kharar/STP-8100L-05/STP-8100L-05 reverse engineering.kicad_pcb

## KiCad design STP-8100L-05 reverse engineering.kicad_pcb (2023-08-08)

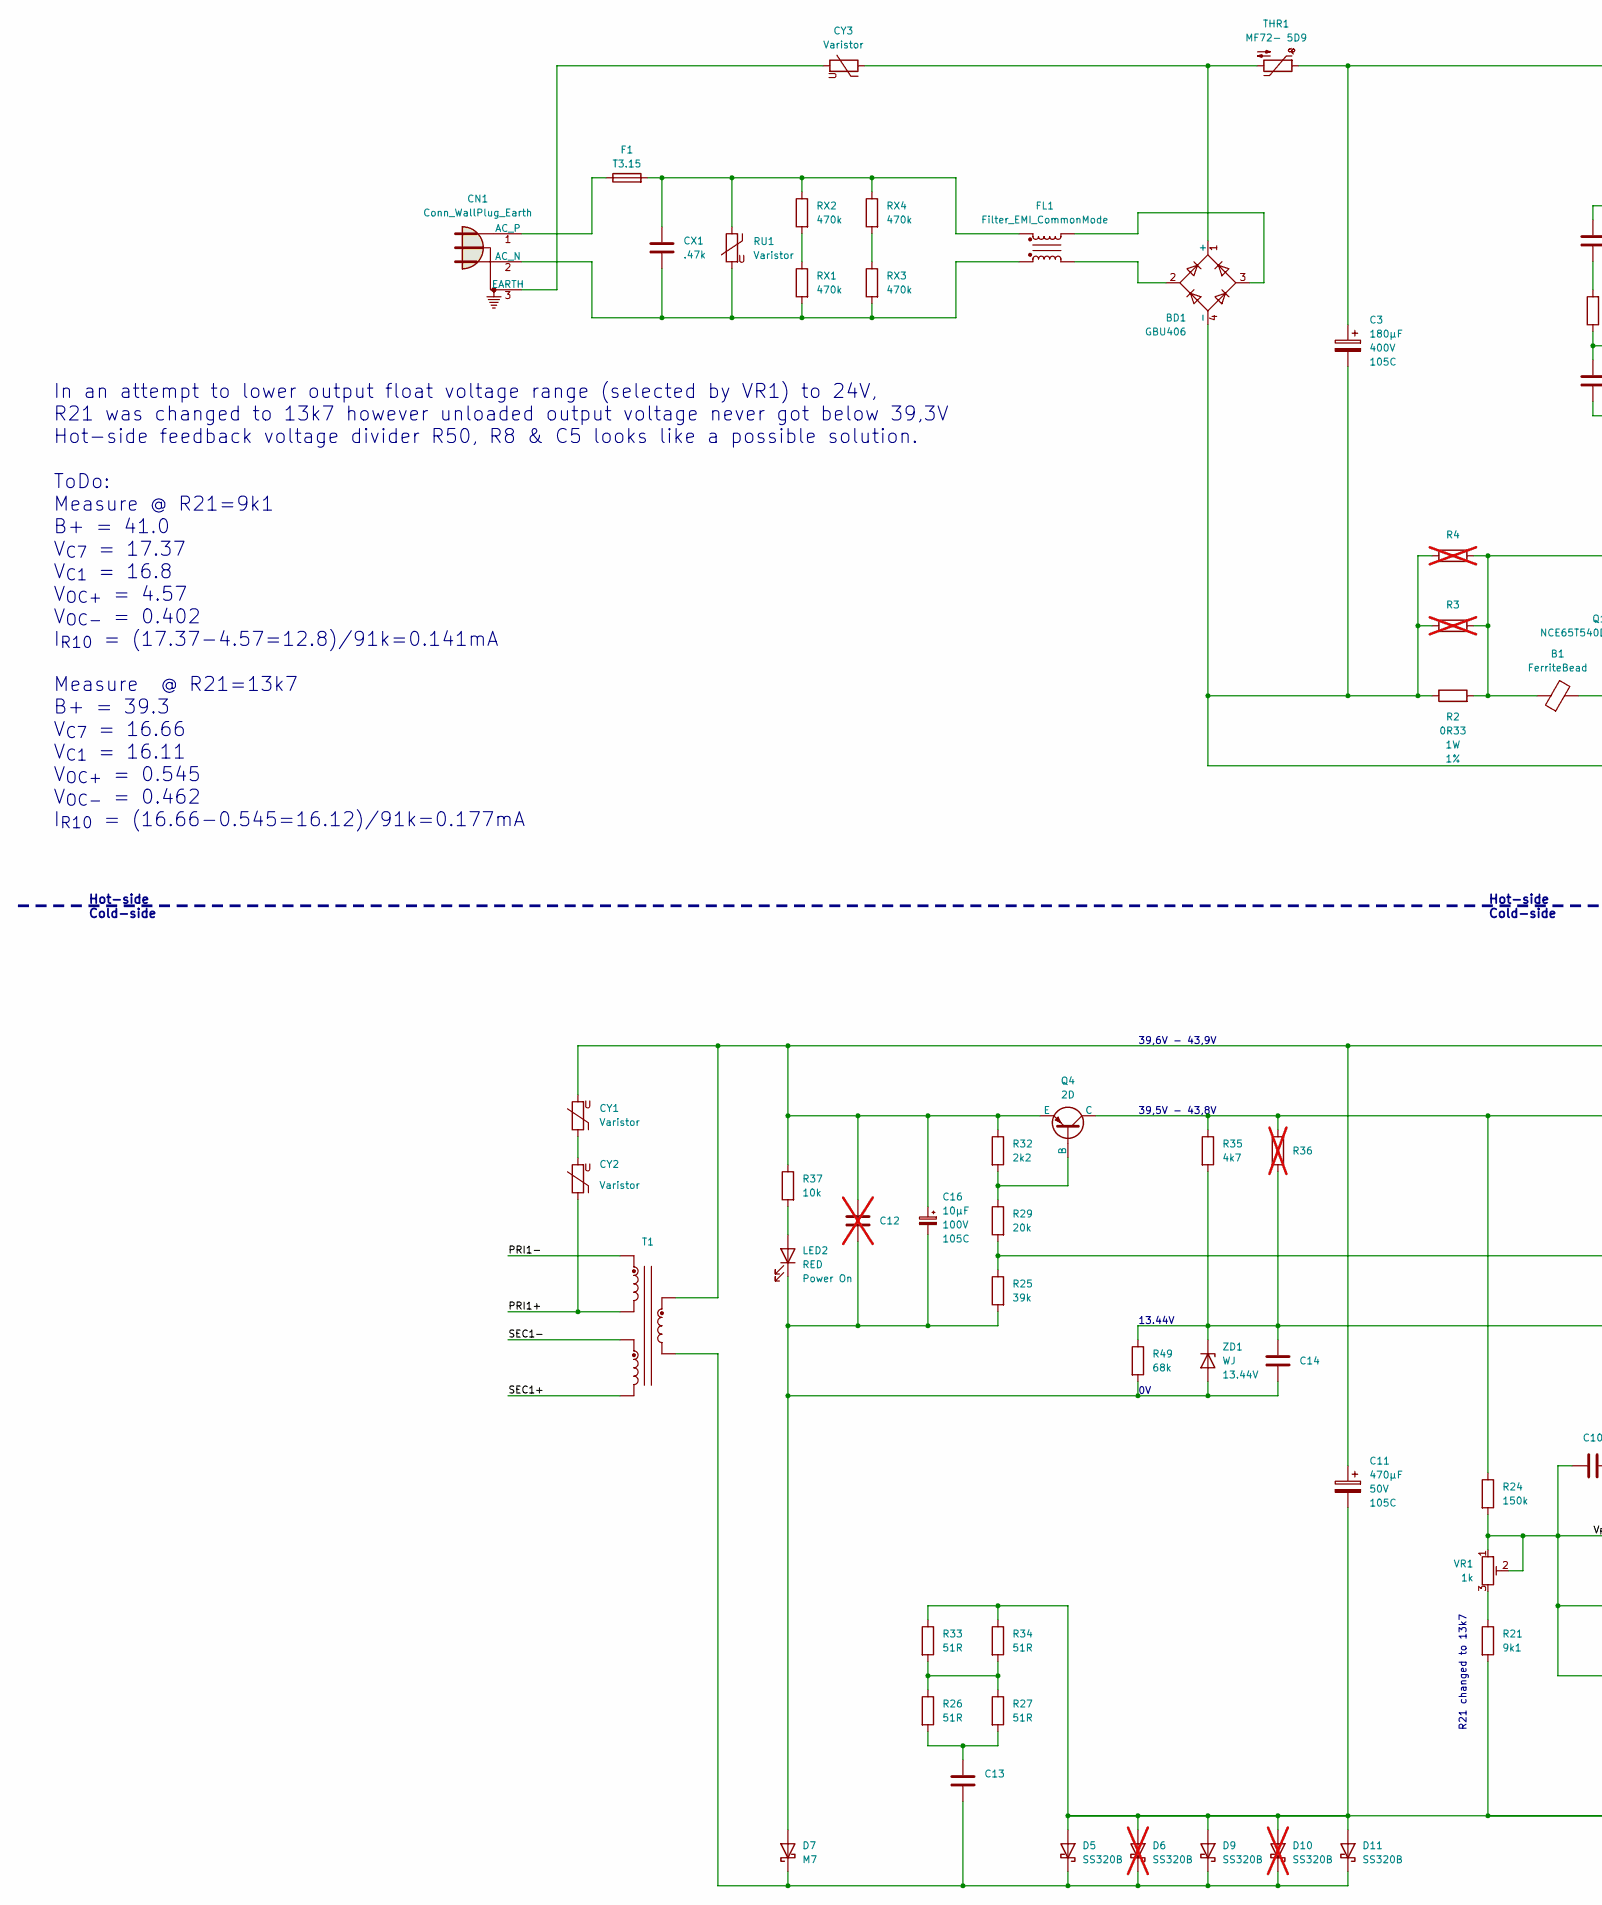
[picture p1: schematic STP-8100L-05 reverse engineering.kicad_sch, part in row 1, column 1]

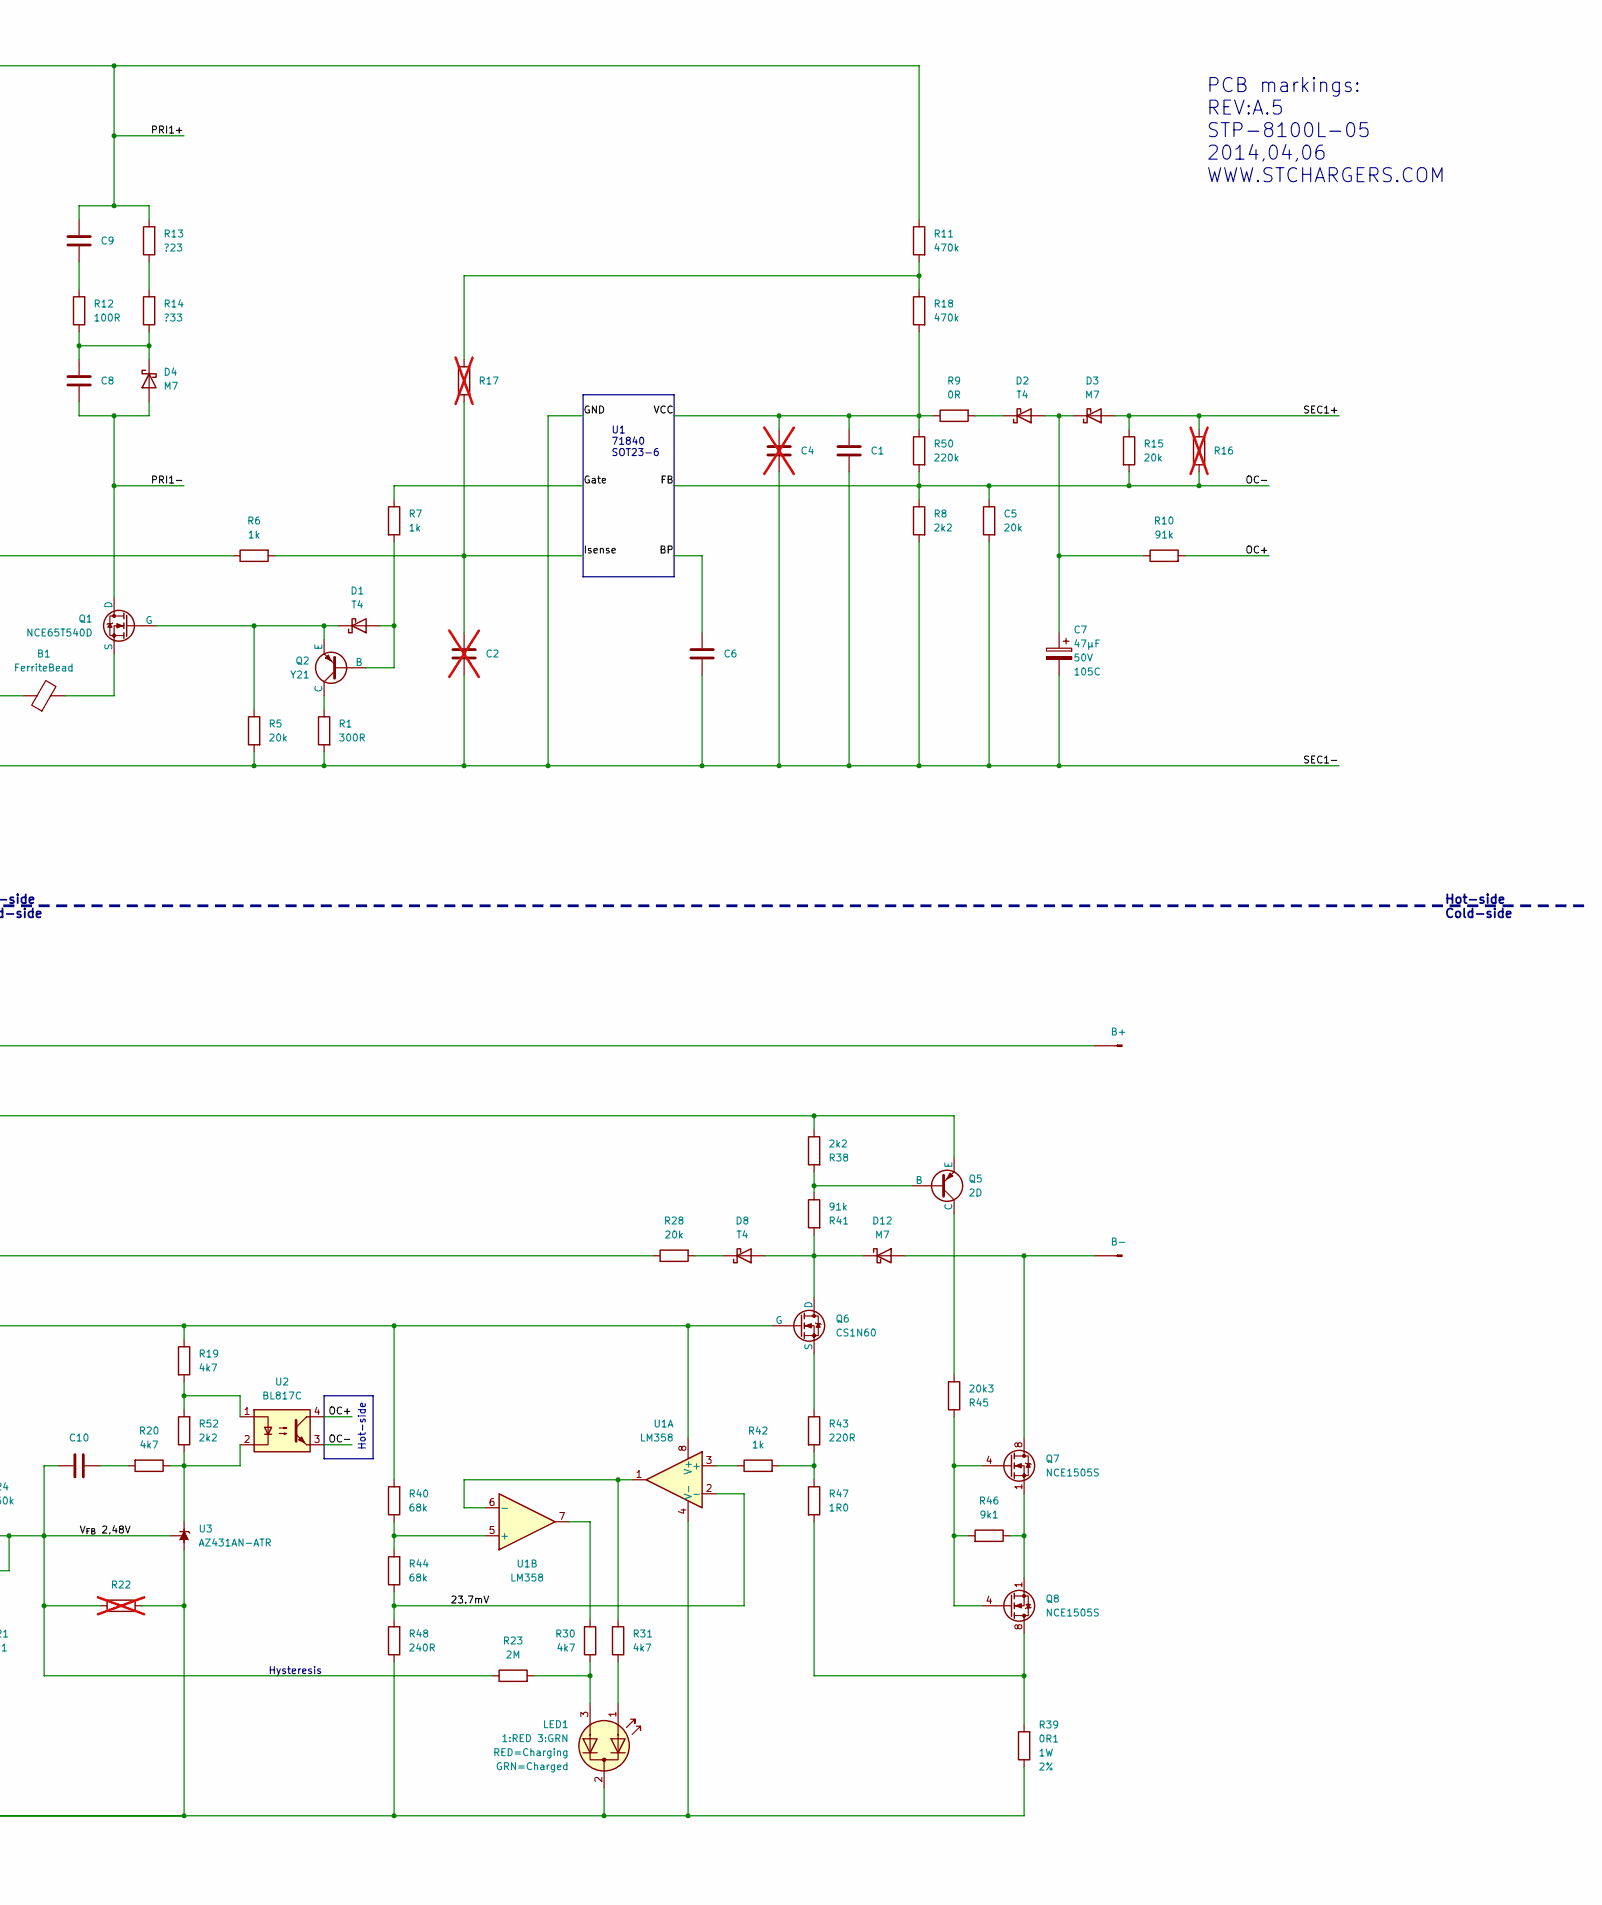
[picture p2: schematic STP-8100L-05 reverse engineering.kicad_sch, part in row 1, column 2]

Parts:
B1: FerriteBead; L_1206_3216Metric
BD1: GBU406; Diode_Bridge_Vishay_GBU
C1, C6, C8, C9, C13: C_1206_3216Metric
C2, C4, C12: C_0805_2012Metric; not fitted
C3: 180µF; CP_Radial_D25.0mm_P10.00mm_SnapIn; Voltage 400V
C5: 20k; R_0805_2012Metric
C7: 47µF; CP_Radial_D6.3mm_P2.50mm; Voltage 50V
C10, C14: C_0805_2012Metric
C11: 470µF; CP_Radial_D12.5mm_P5.00mm; Voltage 50V
C16: 10µF; CP_Radial_D5.0mm_P2.50mm; Voltage 100V
CN1: Conn_WallPlug_Earth
CX1: .47k
CY1, CY2, CY3: Varistor; RV_Disc_D7mm_W3.5mm_P5mm
D1, D2, D8: ?; D_SOD-123
D3, D4, D7, D12: M7; D_SMA
D5, D9, D11: SS320B; D_SMA
D6, D10: SS320B; D_SMA; not fitted
F1: T3.15
FL1: Filter_EMI_CommonMode
J1: B-; TestPoint_THTPad_D4.0mm_Drill2.0mm
J2: B+; TestPoint_THTPad_D4.0mm_Drill2.0mm
LED1: 1:RED 3:GRN; LED_D5.0mm-3
LED2: RED; LED_D5.0mm_Clear
Q1: NCE65T540D; TO-263-3_TabPin2
Q2: Y21; SOT-23
Q4, Q5: 2D; SOT-23
Q6: CS1N60; TO-252-2
Q7, Q8: NCE1505S; SOIC-8_3.9x4.9mm_P1.27mm
R1: 300R; R_1206_3216Metric
R2: 0R33; R_Axial_DIN0516_L15.5mm_D5.0mm_P5.08mm_Vertical; Tolerance 1%
R3, R4, R17: R_1206_3216Metric; not fitted
R5: 20k; R_1206_3216Metric
R6, R42: 1k; R_0805_2012Metric
R7: 1k; R_1206_3216Metric
R8, R32, R38, R52: 2k2; R_0805_2012Metric
R9: 0R; R_1206_3216Metric
R10, R41: 91k; R_0805_2012Metric
R11, R18: 470k; R_1206_3216Metric
R12: 100R; R_1206_3216Metric
R13: ?23; R_1206_3216Metric
R14: ?33; R_1206_3216Metric
R15, R28, R29: 20k; R_0805_2012Metric
R16, R22, R36: R_0805_2012Metric; not fitted
R19, R20, R30, R31, R35: 4k7; R_0805_2012Metric
R21, R46: 9k1; R_0805_2012Metric
R23: 2M; R_0805_2012Metric
R24: 150k; R_0805_2012Metric
R25: 39k; R_0805_2012Metric
R26, R27, R33, R34: 51R; R_0805_2012Metric
R37: 10k; R_0805_2012Metric
R39: 0R1; R_Axial_DIN0516_L15.5mm_D5.0mm_P5.08mm_Vertical; Tolerance 2%
R40, R44, R49: 68k; R_0805_2012Metric
R43: 220R; R_2010_5025Metric
R45: 20k3; R_0805_2012Metric
R47: 1R0; R_0805_2012Metric
R48: 240R; R_0805_2012Metric
R50: 220k; R_0805_2012Metric
RU1: Varistor; RV_Disc_D7mm_W3.5mm_P5mm
RX1, RX2, RX3, RX4: 470k; R_1206_3216Metric
T1: (no value)
THR1: MF72- 5D9
U1: LM358; SO-8_3.9x4.9mm_P1.27mm
U2: BL817C; DIP-4_W7.62mm
U3: AZ431AN-ATR; SOT-23
VR1: 1k; Potentiometer_Bourns_3214J_Horizontal
ZD1: WJ; D_SOD-123; Voltage 13.44V

Connections:
/23.7mV: R44.1, R48.2, U1.2 (-)
/BP: C6.1
/FB: C5.1, R8.1, R15.2, R16.2, R50.2, U2.3
/GND: BD1.4 (-), C1.2, C2.2, C3.2, C4.2, C5.2, C6.2, C7.2, R1.2, R2.1, R3.1, R4.1, R5.2, R8.2, T1.4
/Gate: R7.1
/Isense: C2.1, R6.2, R17.2
/OC+: R10.2, U2.4
/PRI1+: C3.1, C9.1, CY2.1, R11.1, R13.2, T1.6, THR1.1
/PRI1-: C8.2, D4.2 (A), Q1.1 (D), T1.3
/SEC1+: D3.2 (A), R15.1, R16.1, T1.5
/VCC: C1.1, C4.1, R9.1, R18.2, R50.1
/V_{FB} 2,48V: C10.2, R22.1, R23.1, R24.2, U3.2 (REF), VR1.1, VR1.2
unnamed: B1.1, R2.2, R3.2, R4.2, R6.1
unnamed: BD1.1 (+), CY3.1, THR1.2
unnamed: BD1.2, FL1.4
unnamed: BD1.3, FL1.2
unnamed: C9.2, R12.2
unnamed: C10.1, R20.2
unnamed: C13.1, R26.2, R27.2
unnamed: CN1.2 (AC_N), CX1.2, FL1.3, RU1.2, RX1.2, RX3.2
unnamed: CN1.3 (EARTH), CY3.2
unnamed: CN1.1 (AC_P), F1.1
unnamed: CX1.1, F1.2, FL1.1, RU1.1, RX2.1, RX4.1
unnamed: CY1.1, CY2.2
unnamed: D1.2 (A), Q2.2 (B), R7.2
unnamed: D1.1 (K), Q1.2 (G), Q2.3 (E), R5.1
unnamed: C7.1, D2.2 (A), D3.1 (K), R10.1
unnamed: D2.1 (K), R9.2
unnamed: C8.1, D4.1 (K), R12.1, R14.1
unnamed: C12.1, C14.1, C16.2, D7.2 (A), LED2.1 (K), R25.2, R49.2, ZD1.2 (A)
unnamed: D8.1 (K), R28.2
unnamed: C11.2, D5.2 (A), D6.2 (A), D9.2 (A), D10.2 (A), D11.2 (A), LED1.2 (K), R21.2, R22.2, R33.1, R34.1, R39.1, R48.1, U1.4 (V-), U3.3 (A)
unnamed: C13.2, D5.1 (K), D6.1 (K), D7.1 (K), D9.1 (K), D10.1 (K), D11.1 (K), T1.8
unnamed: D12.2 (A), J1.1, Q7.5 (D), Q7.6 (D), Q7.7 (D), Q7.8 (D)
unnamed: D8.2 (A), D12.1 (K), Q6.1 (D), R41.2
unnamed: C11.1, C12.2, C16.1, CY1.2, J2.1, Q4.3 (E), R32.1, R37.1, T1.1
unnamed: LED1.1 (A1), R31.1
unnamed: LED1.3 (A2), R23.2, R30.1
unnamed: LED2.2 (A), R37.2
unnamed: B1.2, Q1.3 (S)
unnamed: Q2.1 (C), R1.1
unnamed: Q4.2 (B), R29.1, R32.2
unnamed: Q4.1 (C), Q5.3 (E), R24.1, R35.1, R36.1, R38.1
unnamed: Q5.2 (B), R38.2, R41.1
unnamed: Q5.1 (C), R45.2
unnamed: C14.2, Q6.2 (G), R19.1, R35.2, R36.2, R40.2, R49.1, U1.8 (V+), ZD1.1 (K)
unnamed: Q6.3 (S), R43.1
unnamed: Q7.4 (G), Q8.4 (G), R45.1, R46.2
unnamed: Q7.1 (S), Q7.2 (S), Q7.3 (S), Q8.1 (S), Q8.2 (S), Q8.3 (S), R46.1
unnamed: Q8.5 (D), Q8.6 (D), Q8.7 (D), Q8.8 (D), R39.2, R47.2
unnamed: R11.2, R17.1, R18.1
unnamed: R13.1, R14.2
unnamed: R19.2, R52.2, U2.1
unnamed: R21.1, VR1.3
unnamed: R25.1, R28.1, R29.2
unnamed: R26.1, R27.1, R33.2, R34.2
unnamed: R30.2, U1.7
unnamed: R42.2, R43.2, R47.1
unnamed: RX1.1, RX2.2
unnamed: RX3.1, RX4.2
unnamed: R42.1, U1.3 (+)
unnamed: R40.1, R44.2, U1.5 (+)
unnamed: R31.2, U1.1, U1.6 (-)
unnamed: R20.1, R52.1, U2.2, U3.1 (K)

Notes on the sheet:
R21 changed to 13k7
13.44V
Hysteresis
Hot-side Cold-side
Hot-side
39,5V - 43,8V
In an attempt to lower output float voltage range (selected by VR1) to 24V, R21 was changed to 13k7 however unloaded output voltage never got below 39,3V Hot-side feedback voltage divider R50, R8 & C5 looks like a possible solution. ToDo: Measure @ R21=9k1 B+ = 41.0 V_{C7} = 17.37 V_{C1} = 16.8 V_{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
U1 71840 SOT23-6
PCB markings: REV:A.5 STP-8100L-05 2014,04,06 WWW.STCHARGERS.COM
39,6V - 43,9V

Board: 2 copper layers, 104 parts (0 on the bottom side), 58 nets, no tracks yet.
