kharar/STP-8100L-05/(commit log)

2023-08-07 Add hot-side to schematics
    [STP-8100L-05 reverse engineering.kicad_pcb, STP-8100L-05 reverse engineering.kicad_sch]
2023-08-08 Rearrange and add measurements
    [STP-8100L-05 reverse engineering.kicad_pcb, STP-8100L-05 reverse engineering.kicad_sch]
2023-09-18 Last commit
    [STP-8100L-05 reverse engineering.kicad_sch]
